astarus-pyxis/scalar-payload/Templates/Template paysage.docx

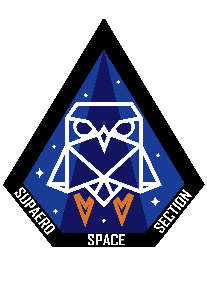
[picture p13: figure]

SCALAR V-a charge utile

Template portrait
