astarus-pyxis/scalar-payload/Templates/Template portrait.docx

SCALAR V-a charge utile

Template portrait
