astarus-pyxis/scalar-payload/Templates/Template_presentation_V2.pptx

## Title of the presentation

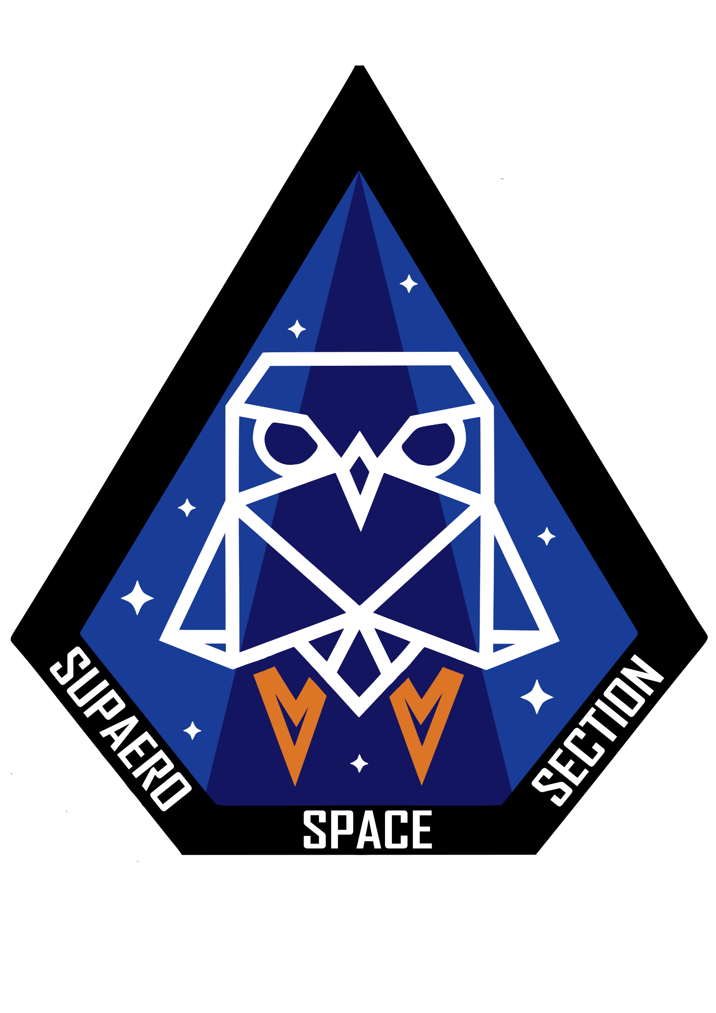
[picture p14: figure]
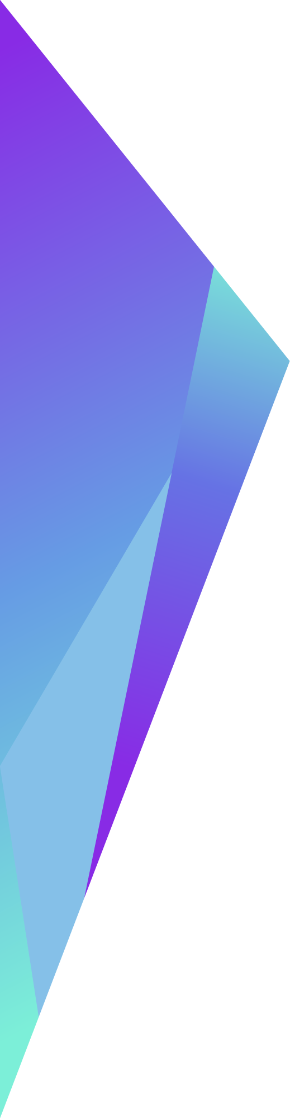
[picture p15: figure]

SUPAERO SPACE SECTION
Name of the project

specification / Occasion

Occasion – Date

## Title of the presentation

SUPAERO SPACE SECTION
Name of the project

specification / Occasion
