astarus-pyxis/scalar-payload/(list of files, cad)

Other CAD files:
CAD/AéroSat_body_v8.CATPart
CAD/AéroSat_top_v8.CATPart
CAD/MuonSat.CATPart
