astarus-pyxis/scalar-payload/Flight results/Données de vol détecteur de muons.csv

Event Ardn_time[ms] ADC[0-1023] SiPM[mV] Deadtime[ms] Temp[C]
1 1243 334 61.44 0 22.19
2 2206 60 17.43 14 22.19
3 4062 71 19.06 30 22.19
4 6426 830 799.25 47 22.19
5 7565 57 16.93 64 22.19
6 7641 78 19.92 84 22.19
7 8046 88 20.96 101 22.19
8 8183 56 16.76 118 22.19
9 8788 575 187.30 135 22.19
10 9098 472 125.87 152 22.19
11 9709 369 73.42 169 22.19
12 11788 63 17.91 186 22.19
13 13323 368 72.93 203 22.19
14 14553 396 85.28 220 22.19
15 14866 408 90.57 237 22.19
16 14931 176 30.09 254 22.19
17 15149 608 202.86 271 22.19
18 16000 433 104.37 288 22.19
19 16210 327 59.28 305 22.19
20 17087 99 21.91 322 22.19
21 17242 312 55.68 339 22.19
22 18424 65 18.22 356 22.19
23 19144 60 17.43 373 22.19
24 19418 467 121.56 393 22.19
25 20193 284 49.41 410 22.19
26 21046 575 187.30 427 22.19
27 21923 63 17.91 444 22.19
28 22632 56 16.76 461 22.19
29 22716 65 18.22 478 22.19
30 23126 615 227.36 495 22.19
31 23327 432 101.61 512 22.19
32 24752 408 90.57 529 22.19
33 24835 430 101.41 546 22.19
34 25262 467 121.56 563 22.19
35 25316 326 59.13 580 22.19
36 25674 287 50.23 597 22.19
37 26672 295 51.75 614 22.19
38 26743 487 132.65 631 22.19
39 26921 96 21.67 648 22.19
40 27774 79 20.03 665 22.19
41 27977 60 17.43 685 22.19
42 27996 536 160.18 702 22.19
43 28986 78 19.92 719 22.19
44 29338 96 21.67 736 22.19
45 29835 78 19.92 753 22.19
46 30540 96 21.67 770 22.19
47 31402 467 121.56 787 22.19
48 31533 63 17.91 804 22.19
49 31625 270 46.71 821 22.19
50 32344 120 23.58 838 22.19
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
3506 2325244 412 92.93 61139 32.18
3507 2326284 472 125.87 61156 32.18
3508 2327026 56 16.76 61174 32.18
3509 2327527 60 17.43 61191 32.18
3510 2328185 480 130.21 61208 32.18
3511 2329618 124 23.92 61225 32.18
3512 2330090 120 23.58 61243 32.18
3513 2331300 327 59.28 61260 32.18
3514 2332745 510 148.47 61277 32.18
3515 2333742 399 87.30 61294 32.18
3516 2333884 115 23.18 61311 32.18
3517 2334018 785 647.86 61329 32.18
3518 2334102 57 16.93 61347 32.18
3519 2335348 432 101.61 61365 32.18
3520 2338347 385 80.11 61386 32.18
3521 2339763 159 27.66 61404 32.18
3522 2339844 192 32.67 61422 32.18
3523 2340632 519 154.30 61440 32.18
3524 2340829 275 47.73 61458 32.18
3525 2340939 231 39.55 61476 32.18
3526 2341144 467 121.56 61494 32.18
3527 2342074 344 64.67 61512 32.18
3528 2342597 595 212.63 61529 32.18
3529 2342628 415 95.00 61546 32.18
3530 2343134 76 19.69 61563 32.18
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
