astarus-pyxis/scalar-payload/Flight results/Courbes/Amplitude signaux.png

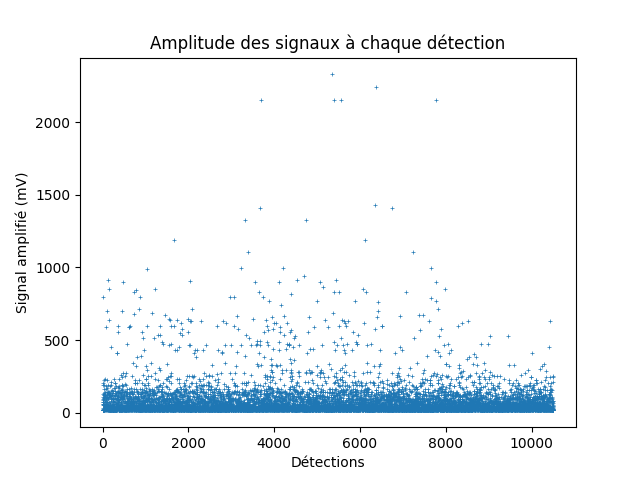
Flight results/Courbes/Amplitude signaux.png
