astarus-pyxis/scalar-payload/Flight results/Courbes/Niveaux ADC.png

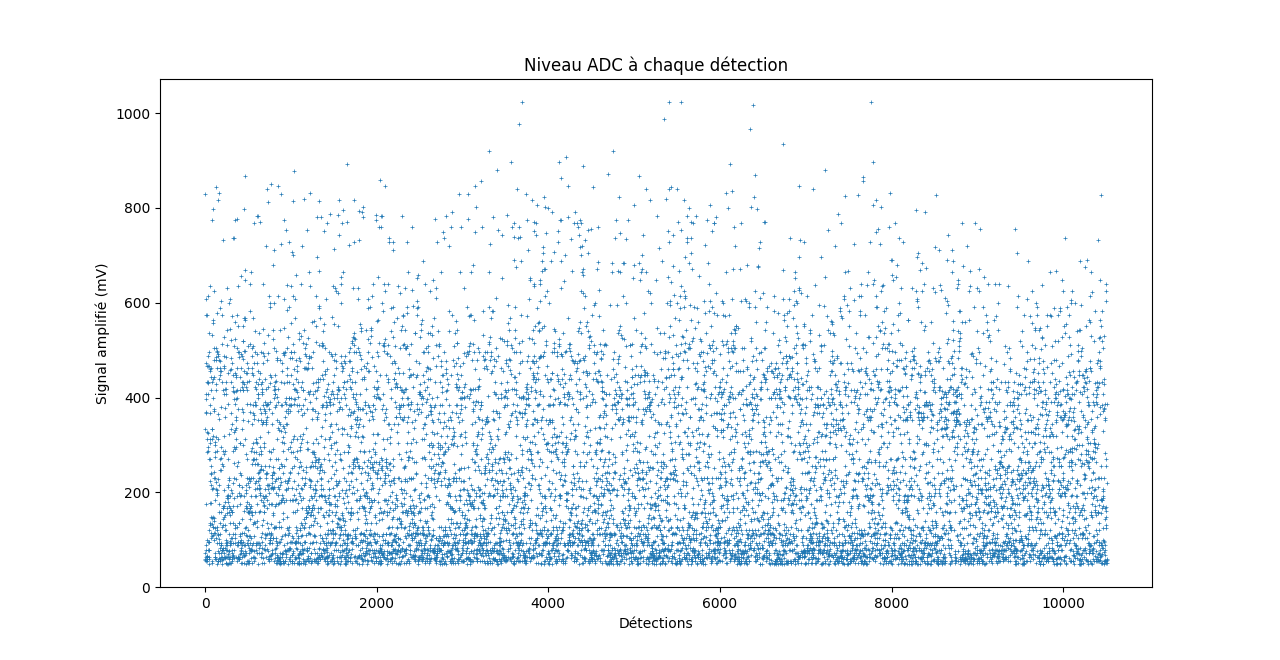
Flight results/Courbes/Niveaux ADC.png
