astarus-pyxis/scalar-payload/Flight results/Courbes/Réparition amplitudes signaux.png

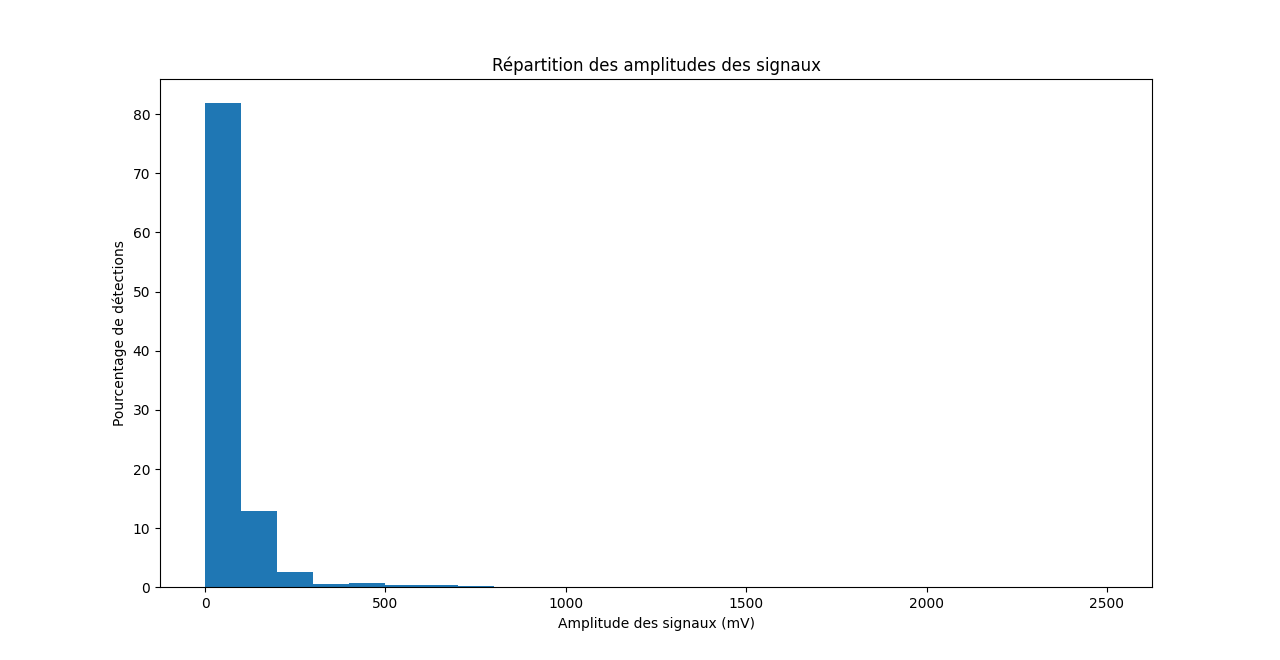
Flight results/Courbes/Réparition amplitudes signaux.png
