astarus-pyxis/scalar-payload/Flight results/Courbes/Répartition niveaux ADC.png

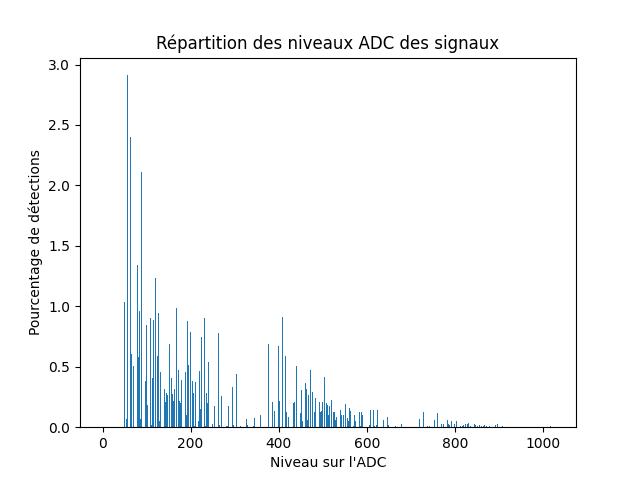
Flight results/Courbes/Répartition niveaux ADC.png
