astarus-pyxis/scalar-payload/Flight results/Courbes/Super zoom répartition amplitudes signaux.png

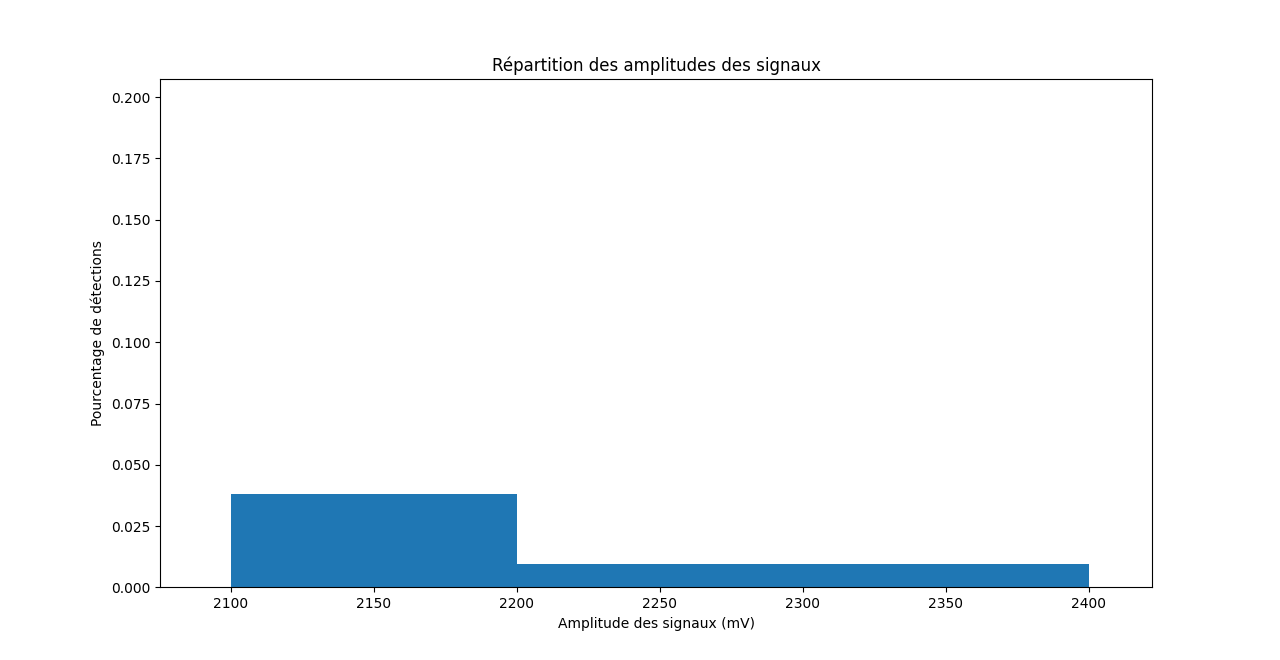
Flight results/Courbes/Super zoom répartition amplitudes signaux.png
