astarus-pyxis/scalar-payload/Flight results/Courbes/Temps entre détections.png

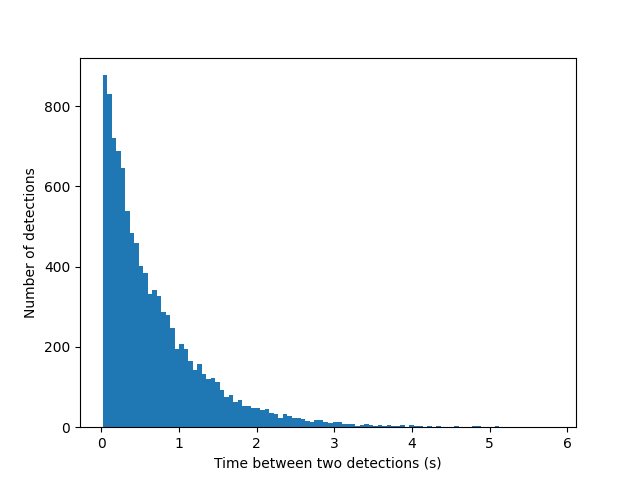
Flight results/Courbes/Temps entre détections.png
