astarus-pyxis/scalar-payload/Flight results/Courbes/Zoom amplitude.png

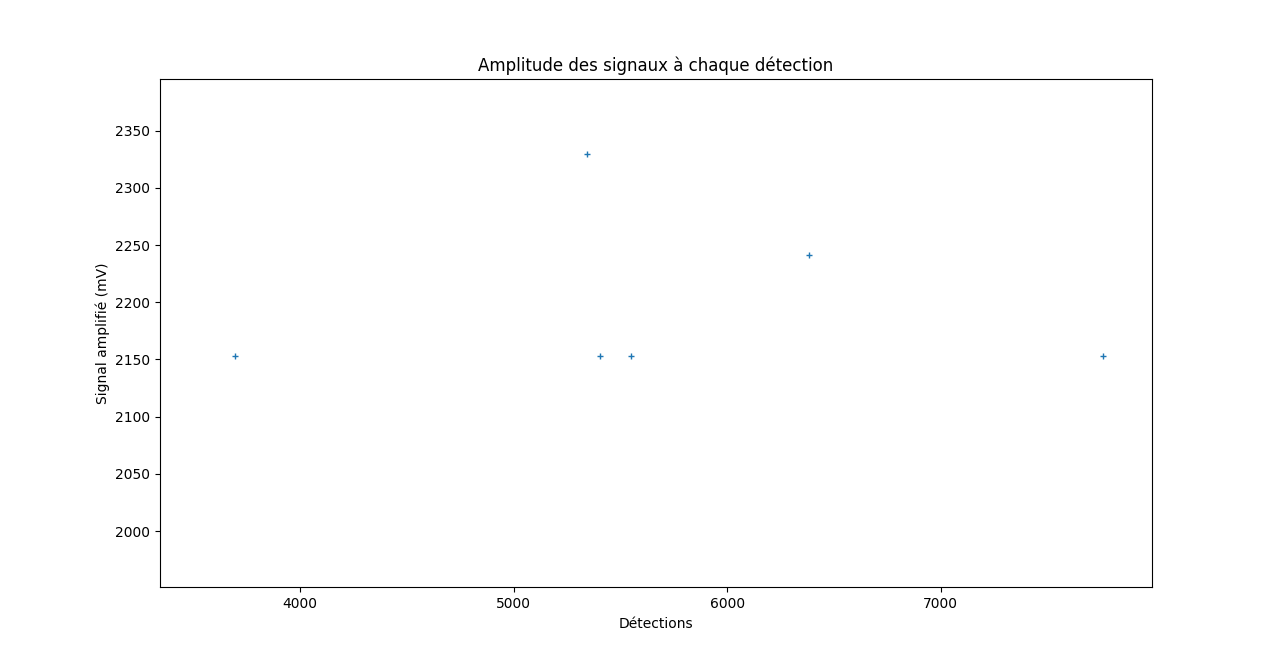
Flight results/Courbes/Zoom amplitude.png
