astarus-pyxis/scalar-payload/Flight results/Courbes/Zoom nombre de muons au cours du temps.png

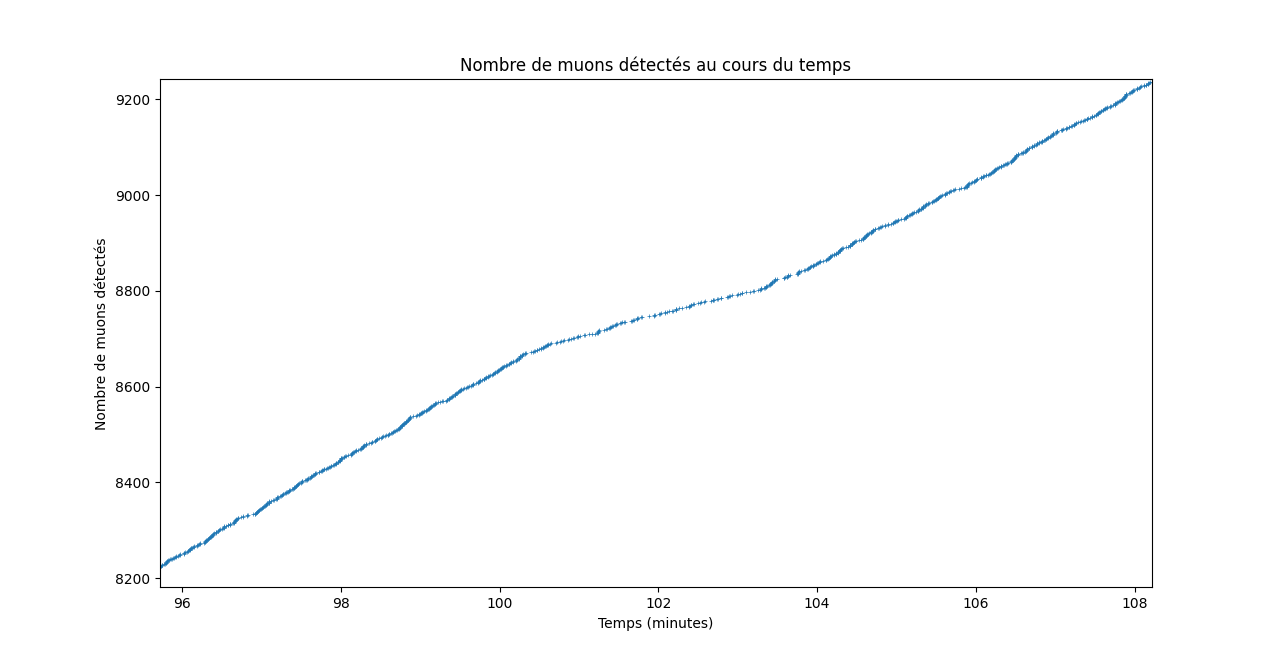
Flight results/Courbes/Zoom nombre de muons au cours du temps.png
