astarus-pyxis/scalar-payload/Flight results/Courbes/Zoom répartition niveaux ADC.png

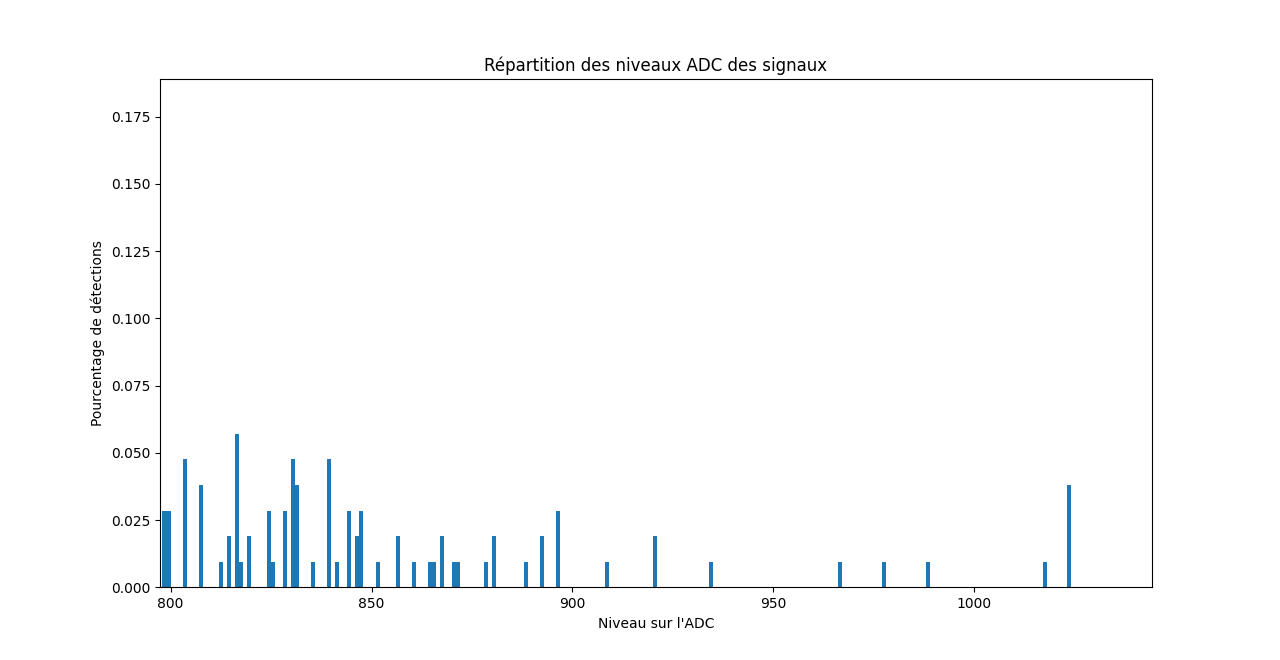
Flight results/Courbes/Zoom répartition niveaux ADC.png
