astarus-pyxis/scalar-payload/Electronics/AeroSat board/SCALARV_Cansat_Board_Pico.kicad_pcb

## KiCad design Electronics/AeroSat board/SCALARV_Cansat_Board_Pico.kicad_pcb (2024-07-04)

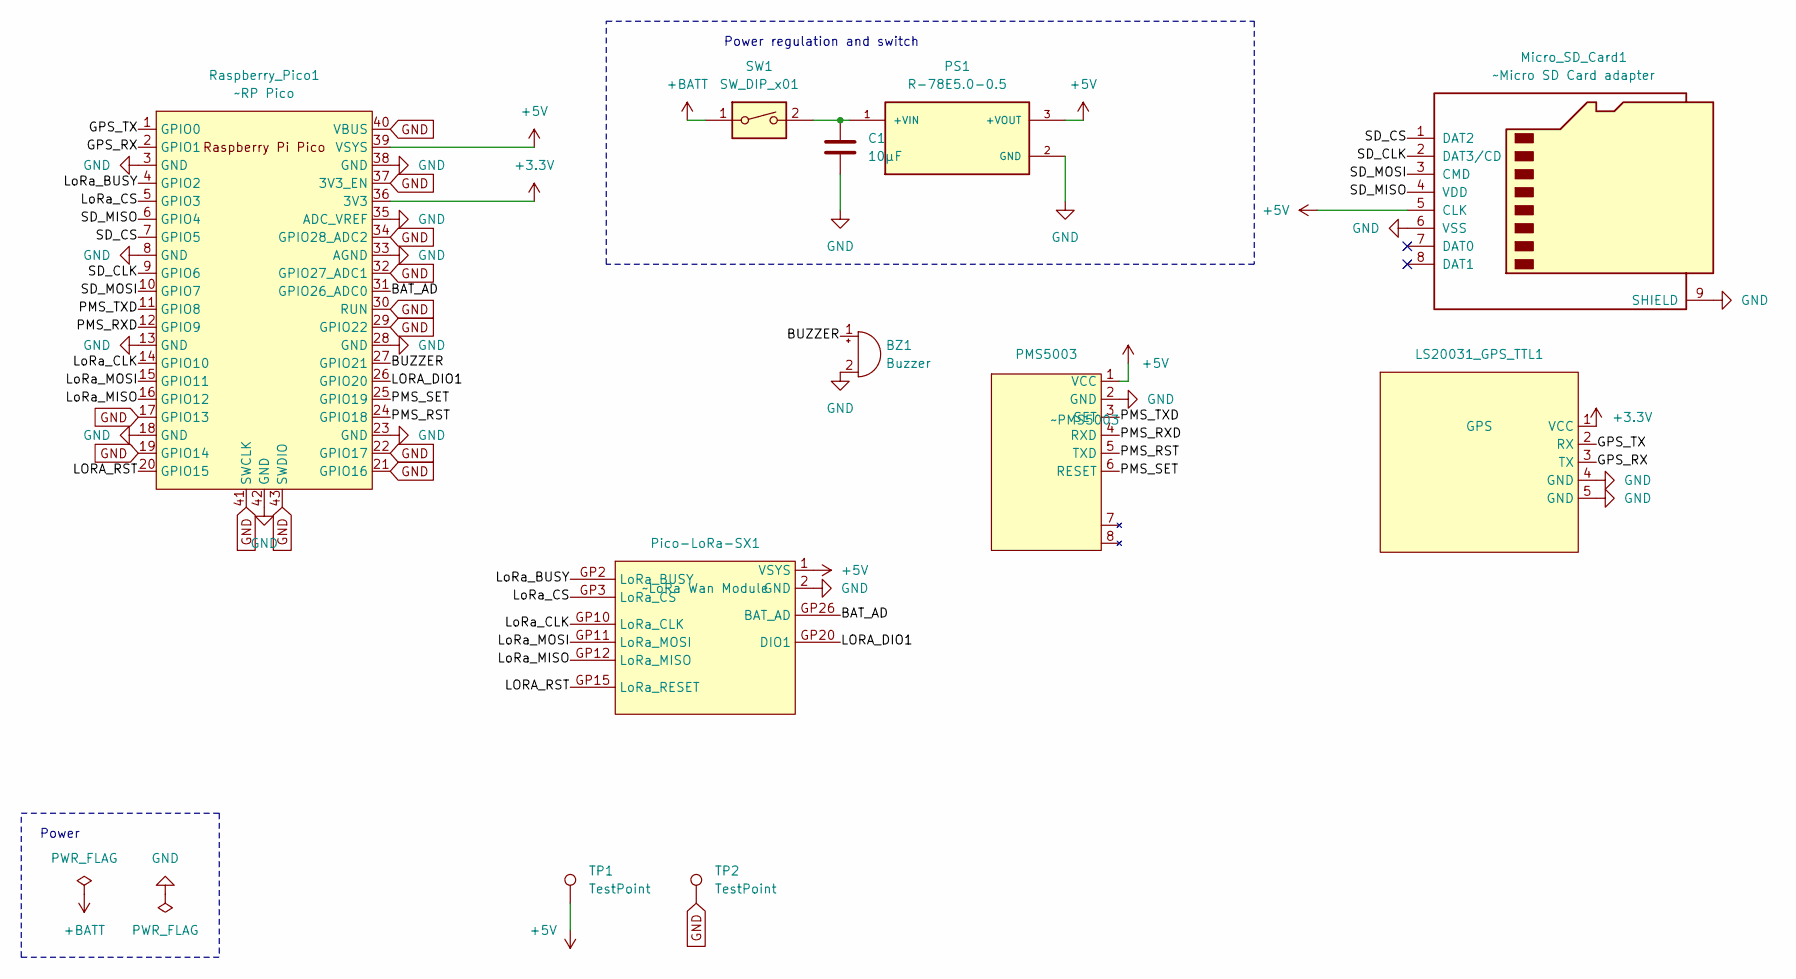
[picture p25: schematic SCALARV_Cansat_Board_Pico.kicad_sch, AEROSAT_MAIN_BOARD]

Parts:
BZ1: Buzzer; Buzzer_12x9.5RM7.6
C1: 10µF; FA23
LS20031_GPS_TTL1: GPS; LS20031_GPS_Vertical
Micro_SD_Card1: ~Micro SD Card adapter; Catalex_microSD_adaptater
PMS5003: ~PMS5003; PIM477
PS1: R-78E5.0-0.5; CONV_R-78E5.0-0.5; PARTREV 4
Pico-LoRa-SX1: ~LoRa Wan Module
Raspberry_Pico1: ~RP Pico; RPi_Pico_SMD_TH
SW1: SW_DIP_x01; SW_DIP_SPSTx01_Slide_9.78x4.72mm_W7.62mm_P2.54mm
TP1, TP2: TestPoint; TestPoint_Pad_D1.0mm

Connections:
+3.3V: LS20031_GPS_TTL1.1 (VCC), Raspberry_Pico1.36 (3V3)
+5V: Micro_SD_Card1.5 (CLK), PMS5003.1 (VCC), PS1.3 (+VOUT), Pico-LoRa-SX1.1 (VSYS), Raspberry_Pico1.39 (VSYS), TP1.1
+BATT: SW1.1
/BAT_AD: Pico-LoRa-SX1.GP26 (BAT_AD), Raspberry_Pico1.31 (GPIO26_ADC0)
/BUZZER: BZ1.1 (+), Raspberry_Pico1.27 (GPIO21)
/GPS_RX: LS20031_GPS_TTL1.3 (TX), Raspberry_Pico1.2 (GPIO1)
/GPS_TX: LS20031_GPS_TTL1.2 (RX), Raspberry_Pico1.1 (GPIO0)
/LORA_DIO1: Pico-LoRa-SX1.GP20 (DIO1), Raspberry_Pico1.26 (GPIO20)
/LORA_RST: Pico-LoRa-SX1.GP15 (LoRa_RESET), Raspberry_Pico1.20 (GPIO15)
/LoRa_BUSY: Pico-LoRa-SX1.GP2 (LoRa_BUSY), Raspberry_Pico1.4 (GPIO2)
/LoRa_CLK: Pico-LoRa-SX1.GP10 (LoRa_CLK), Raspberry_Pico1.14 (GPIO10)
/LoRa_CS: Pico-LoRa-SX1.GP3 (LoRa_CS), Raspberry_Pico1.5 (GPIO3)
/LoRa_MISO: Pico-LoRa-SX1.GP12 (LoRa_MISO), Raspberry_Pico1.16 (GPIO12)
/LoRa_MOSI: Pico-LoRa-SX1.GP11 (LoRa_MOSI), Raspberry_Pico1.15 (GPIO11)
/PMS_RST: PMS5003.5 (TXD), Raspberry_Pico1.24 (GPIO18)
/PMS_RXD: PMS5003.4 (RXD), Raspberry_Pico1.12 (GPIO9)
/PMS_SET: PMS5003.6 (RESET), Raspberry_Pico1.25 (GPIO19)
/PMS_TXD: PMS5003.3 (SET), Raspberry_Pico1.11 (GPIO8)
/SD_CLK: Micro_SD_Card1.2 (DAT3/CD), Raspberry_Pico1.9 (GPIO6)
/SD_CS: Micro_SD_Card1.1 (DAT2), Raspberry_Pico1.7 (GPIO5)
/SD_MISO: Micro_SD_Card1.4 (VDD), Raspberry_Pico1.6 (GPIO4)
/SD_MOSI: Micro_SD_Card1.3 (CMD), Raspberry_Pico1.10 (GPIO7)
GND: BZ1.2 (-), C1.2, LS20031_GPS_TTL1.4 (GND), LS20031_GPS_TTL1.5 (GND), Micro_SD_Card1.6 (VSS), Micro_SD_Card1.9 (SHIELD), PMS5003.2 (GND), PS1.2 (GND), Pico-LoRa-SX1.2 (GND), Raspberry_Pico1.3 (GND), Raspberry_Pico1.8 (GND), Raspberry_Pico1.13 (GND), Raspberry_Pico1.17 (GPIO13), Raspberry_Pico1.18 (GND), Raspberry_Pico1.19 (GPIO14), Raspberry_Pico1.21 (GPIO16), Raspberry_Pico1.22 (GPIO17), Raspberry_Pico1.23 (GND), Raspberry_Pico1.28 (GND), Raspberry_Pico1.29 (GPIO22), Raspberry_Pico1.30 (RUN), Raspberry_Pico1.32 (GPIO27_ADC1), Raspberry_Pico1.33 (AGND), Raspberry_Pico1.34 (GPIO28_ADC2), Raspberry_Pico1.35 (ADC_VREF), Raspberry_Pico1.37 (3V3_EN), Raspberry_Pico1.38 (GND), Raspberry_Pico1.40 (VBUS), Raspberry_Pico1.41 (SWCLK), Raspberry_Pico1.42 (GND), Raspberry_Pico1.43 (SWDIO), TP2.1
unnamed: C1.1, PS1.1 (+VIN), SW1.2

Notes on the sheet:
Power regulation and switch
Power

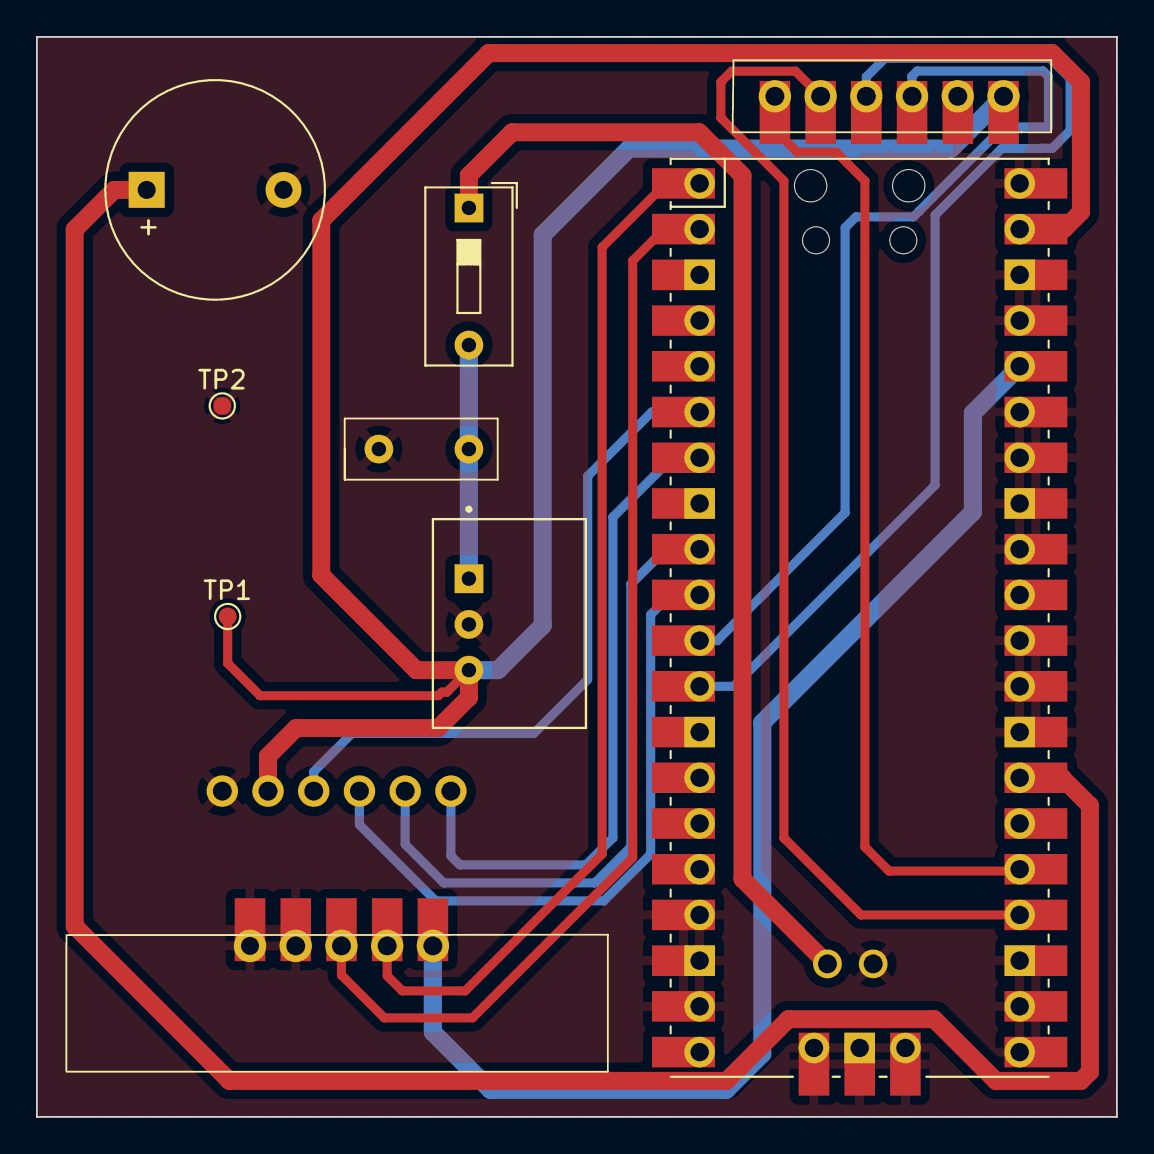
[picture p26: board SCALARV_Cansat_Board_Pico.kicad_pcb from above]

Board: 2 copper layers, 60.0 x 60.0 mm, 10 parts (0 on the bottom side), 15 nets.
