astarus-pyxis/scalar-payload/Flight Software/AéroSat/Raspberry Pi Pico/Final code/L76/micropyGPS/pyboard/good_sentences.py

from machine import UART
from L76.micropyGPS.micropyGPS import MicropyGPS

uart = UART(0, 57600)

my_gps = MicropyGPS()


# Reads 300 sentences and reports how many were parsed and if any failed the CRC check
sentence_count = 0
while True:
    if uart.any():
        stat = my_gps.update(chr(uart.readline()))
        if stat:
            print(stat)
            stat = None
            sentence_count += 1
    if sentence_count == 300:
        break;    


print('Sentences Found:', my_gps.clean_sentences)
print('Sentences Parsed:', my_gps.parsed_sentences)
print('CRC_Fails:', my_gps.crc_fails)
